colej4/drone/flight-controller/BMI270/BMI270.step

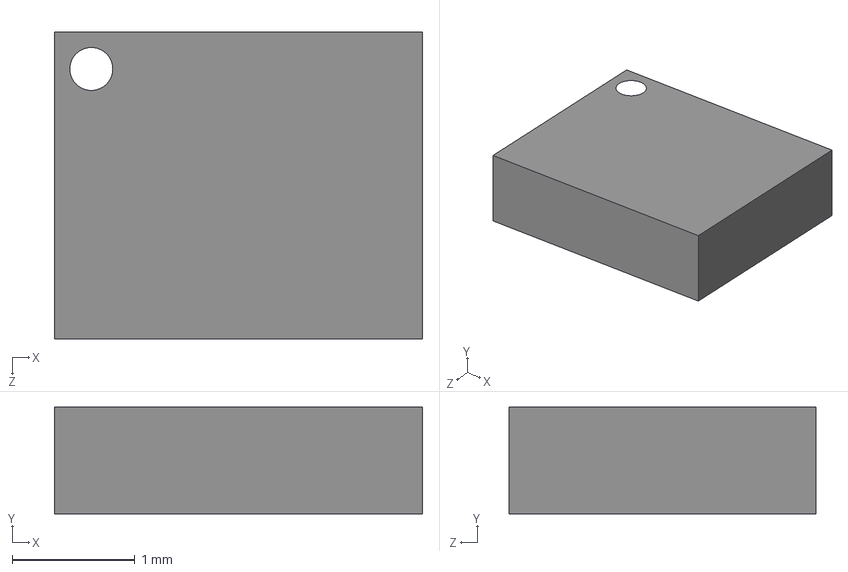
[picture p1: CAD file, 2026-03-21]
flight-controller/BMI270/BMI270.step
3.00 x 0.87 x 2.50 mm
