colej4/drone/flight-controller/BMP581/BMP581.step

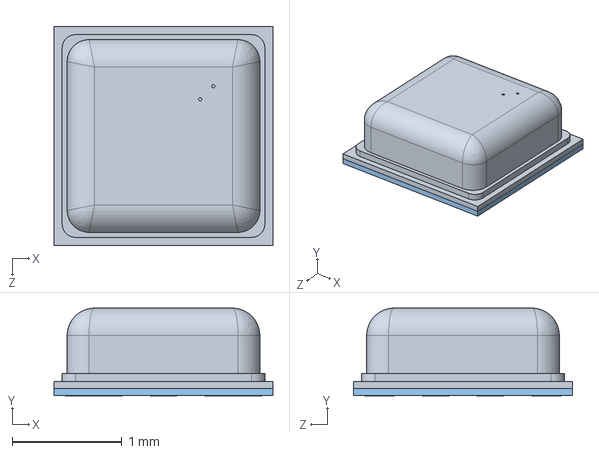
[picture p2: CAD file, 2026-03-21]
flight-controller/BMP581/BMP581.step
2.00 x 0.801 x 2.00 mm
