colej4/drone/flight-controller/MMC5983MA/MMC5983MA.step

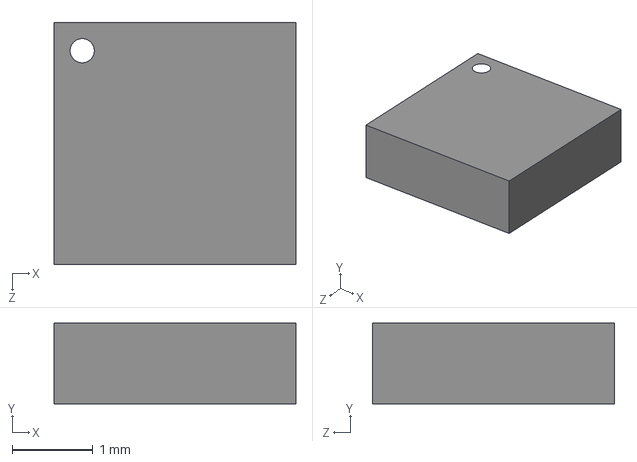
[picture p3: CAD file, 2026-03-21]
flight-controller/MMC5983MA/MMC5983MA.step
3.00 x 1.00 x 3.00 mm
