colej4/drone/flight-controller/MSD_4_A/MSD-4-A.step

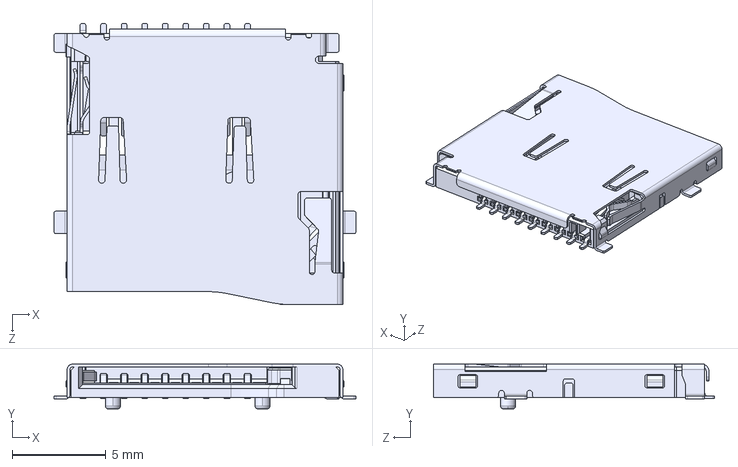
[picture p4: CAD file, 2026-03-25]
flight-controller/MSD_4_A/MSD-4-A.step
16.1 x 2.40 x 15.0 mm
