colej4/drone/flight-controller/TPS629210DRLR/TPS629210DRLR.step

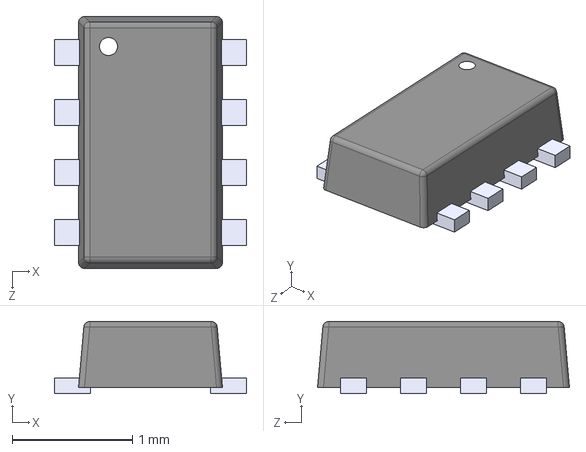
[picture p5: CAD file, 2026-03-25]
flight-controller/TPS629210DRLR/TPS629210DRLR.step
1.60 x 0.6 x 2.10 mm
