colej4/drone/flight-controller/FlightController.kicad_pcb

## KiCad design flight-controller/FlightController.kicad_pcb (2026-03-29)

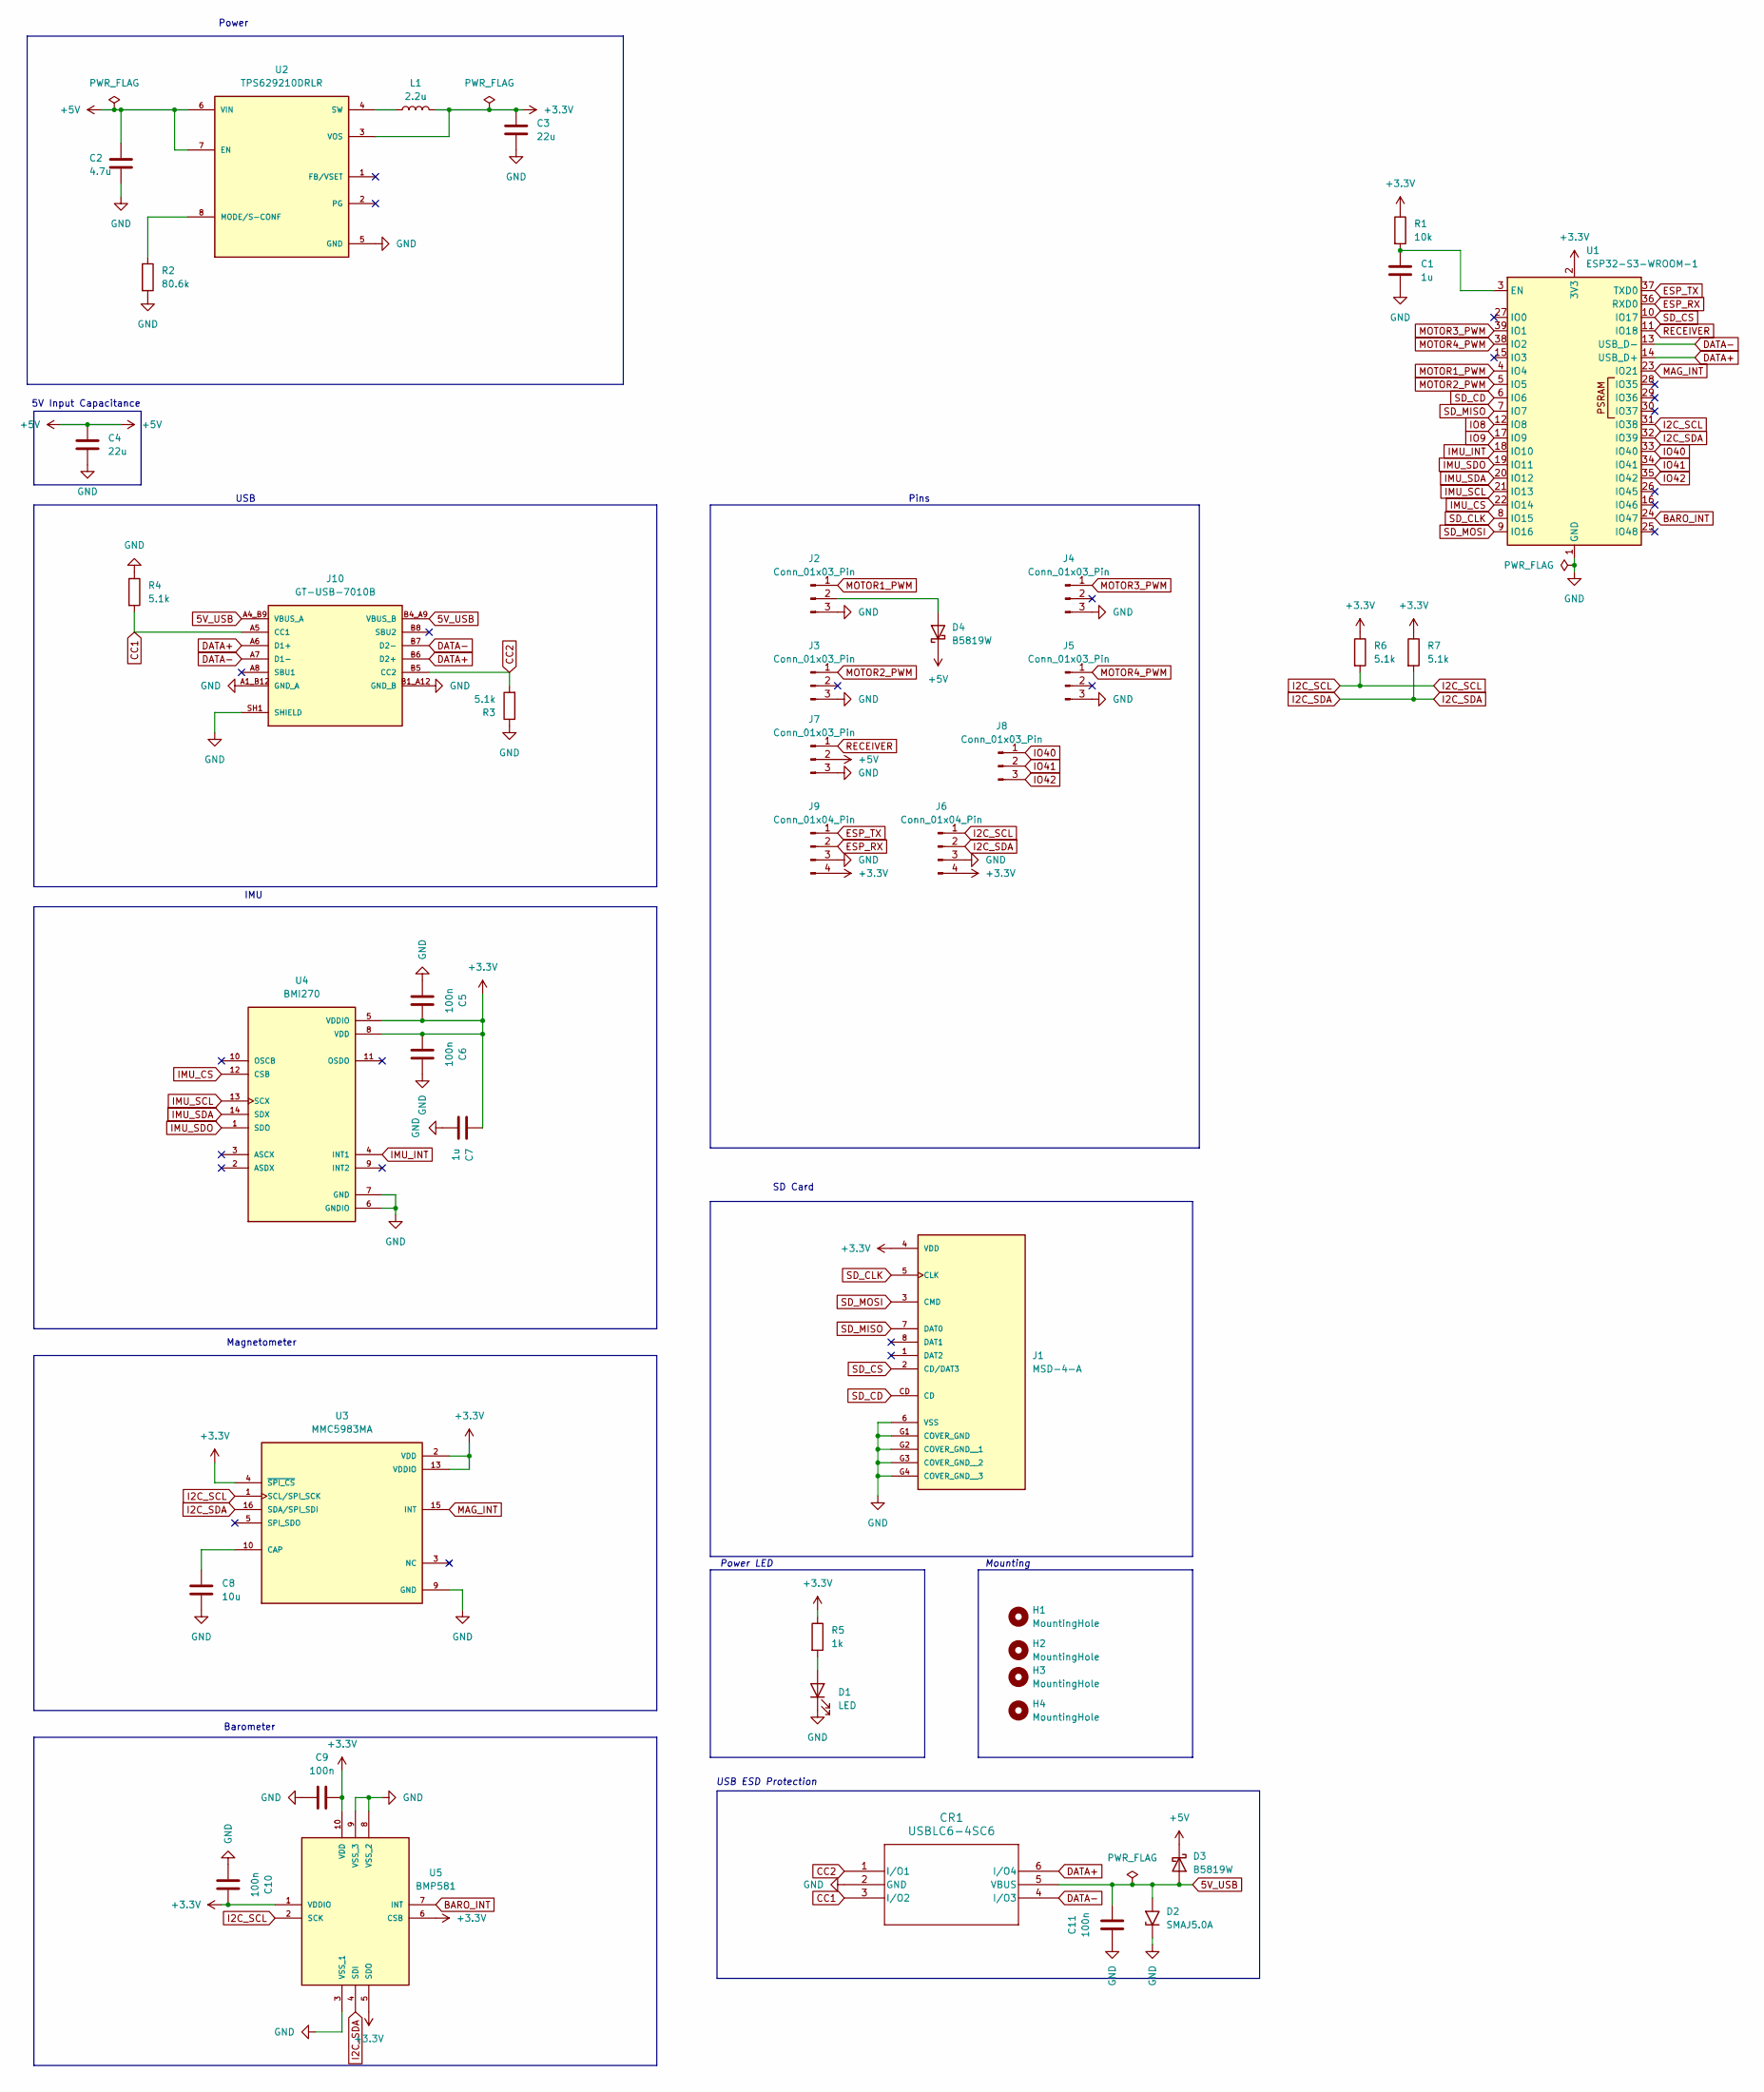
[picture p6: schematic FlightController.kicad_sch]

Parts:
C1, C7: 1u; C_0603_1608Metric_Pad1.08x0.95mm_HandSolder
C2: 4.7u; C_0603_1608Metric_Pad1.08x0.95mm_HandSolder
C3, C4: 22u; C_0603_1608Metric_Pad1.08x0.95mm_HandSolder
C5, C6, C9, C10, C11: 100n; C_0603_1608Metric_Pad1.08x0.95mm_HandSolder
C8: 10u; C_0603_1608Metric_Pad1.08x0.95mm_HandSolder
CR1: USBLC6-4SC6; SOT23-6L_STM
D1: LED; LED_0805_2012Metric
D2: SMAJ5.0A; D_SMA
D3, D4: B5819W; D_SOD-123
H1, H2, H3, H4: MountingHole; MountingHole_3.2mm_M3
J1: MSD-4-A; CUI_MSD-4-A; PARTREV 1.0
J2, J3, J4, J5, J7, J8: Conn_01x03_Pin; PinHeader_1x03_P2.54mm_Vertical
J6, J9: Conn_01x04_Pin; PinHeader_1x04_P2.54mm_Vertical
J10: GT-USB-7010B; G-SWITCH_GT-USB-7010B; PARTREV A0
L1: 2.2u; L_1008_2520Metric_Pad1.43x2.20mm_HandSolder
R1: 10k; R_0603_1608Metric_Pad0.98x0.95mm_HandSolder
R2: 80.6k; R_0603_1608Metric_Pad0.98x0.95mm_HandSolder
R3, R4, R6, R7: 5.1k; R_0603_1608Metric_Pad0.98x0.95mm_HandSolder
R5: 1k; R_0603_1608Metric_Pad0.98x0.95mm_HandSolder
U1: ESP32-S3-WROOM-1
U2: TPS629210DRLR; SOT50P160X60-8N; PARTREV B
U3: MMC5983MA; PQFN50P300X300X100-16N; PARTREV A
U4: BMI270; XDCR_BMI270
U5: BMP581; Manufacturer_Part_Number BMP581

Connections:
5V_USB: C11.2, CR1.5 (VBUS), D2.2 (A2), D3.2 (A), J10.A4_B9 (VBUS_A), J10.B4_A9 (VBUS_B)
+3.3V: C3.1, C5.2, C6.1, C7.2, C9.2, C10.2, J1.4 (VDD), J6.4, J9.4, L1.2, R1.1, R5.1, R6.1, R7.1, U1.2 (3V3), U2.3 (VOS), U3.2 (VDD), U3.4 (~SPI_CS), U3.13 (VDDIO), U4.5 (VDDIO), U4.8 (VDD), U5.1 (VDDIO), U5.5 (SDO), U5.6 (CSB), U5.10 (VDD)
+5V: C2.2, C4.1, D3.1 (K), D4.1 (K), J7.2, U2.6 (VIN), U2.7 (EN)
BARO_INT: U1.24 (IO47), U5.7 (INT)
CC1: CR1.3 (I/O2), J10.A5 (CC1), R4.2
CC2: CR1.1 (I/O1), J10.B5 (CC2), R3.2
DATA+: CR1.6 (I/O4), J10.A6 (D1+), J10.B6 (D2+), U1.14 (USB_D+)
DATA-: CR1.4 (I/O3), J10.A7 (D1-), J10.B7 (D2-), U1.13 (USB_D-)
ESP_RX: J9.2, U1.36 (RXD0)
ESP_TX: J9.1, U1.37 (TXD0)
GND: C1.2, C2.1, C3.2, C4.2, C5.1, C6.2, C7.1, C8.2, C9.1, C10.1, C11.1, CR1.2 (GND), D1.1 (K), D2.1 (A1), J1.6 (VSS), J1.G1 (COVER_GND), J1.G2 (COVER_GND__1), J1.G3 (COVER_GND__2), J1.G4 (COVER_GND__3), J2.3, J3.3, J4.3, J5.3, J6.3, J7.3, J9.3, J10.A1_B12 (GND_A), J10.B1_A12 (GND_B), J10.SH1 (SHIELD), J10.SH2 (SHIELD), J10.SH3 (SHIELD), J10.SH4 (SHIELD), R2.2, R3.1, R4.1, U1.1 (GND), U1.40 (GND), U1.41 (GND), U2.5 (GND), U3.9 (GND), U3.11 (GND), U4.6 (GNDIO), U4.7 (GND), U5.3 (VSS_1), U5.8 (VSS_2), U5.9 (VSS_3)
I2C_SCL: J6.1, R6.2, U1.31 (IO38), U3.1 (SCL/SPI_SCK), U5.2 (SCK)
I2C_SDA: J6.2, R7.2, U1.32 (IO39), U3.16 (SDA/SPI_SDI), U5.4 (SDI)
IMU_CS: U1.22 (IO14), U4.12 (CSB)
IMU_INT: U1.18 (IO10), U4.4 (INT1)
IMU_SCL: U1.21 (IO13), U4.13 (SCX)
IMU_SDA: U1.20 (IO12), U4.14 (SDX)
IMU_SDO: U1.19 (IO11), U4.1 (SDO)
IO8: U1.12 (IO8)
IO9: U1.17 (IO9)
IO40: J8.1, U1.33 (IO40)
IO41: J8.2, U1.34 (IO41)
IO42: J8.3, U1.35 (IO42)
MAG_INT: U1.23 (IO21), U3.15 (INT)
MOTOR1_PWM: J2.1, U1.4 (IO4)
MOTOR2_PWM: J3.1, U1.5 (IO5)
MOTOR3_PWM: J4.1, U1.39 (IO1)
MOTOR4_PWM: J5.1, U1.38 (IO2)
unnamed: D1.2 (A), R5.2
unnamed: D4.2 (A), J2.2
unnamed: C1.1, R1.2, U1.3 (EN)
unnamed: R2.1, U2.8 (MODE/S-CONF)
unnamed: L1.1, U2.4 (SW)
unnamed: C8.1, U3.10 (CAP)
RECEIVER: J7.1, U1.11 (IO18)
SD_CD: J1.CD, U1.6 (IO6)
SD_CLK: J1.5 (CLK), U1.8 (IO15)
SD_CS: J1.2 (CD/DAT3), U1.10 (IO17)
SD_MISO: J1.7 (DAT0), U1.7 (IO7)
SD_MOSI: J1.3 (CMD), U1.9 (IO16)

Notes on the sheet:
Magnetometer
Mounting
5V Input Capacitance
Pins
USB ESD Protection
SD Card
Barometer
Power LED
USB
IMU
Power

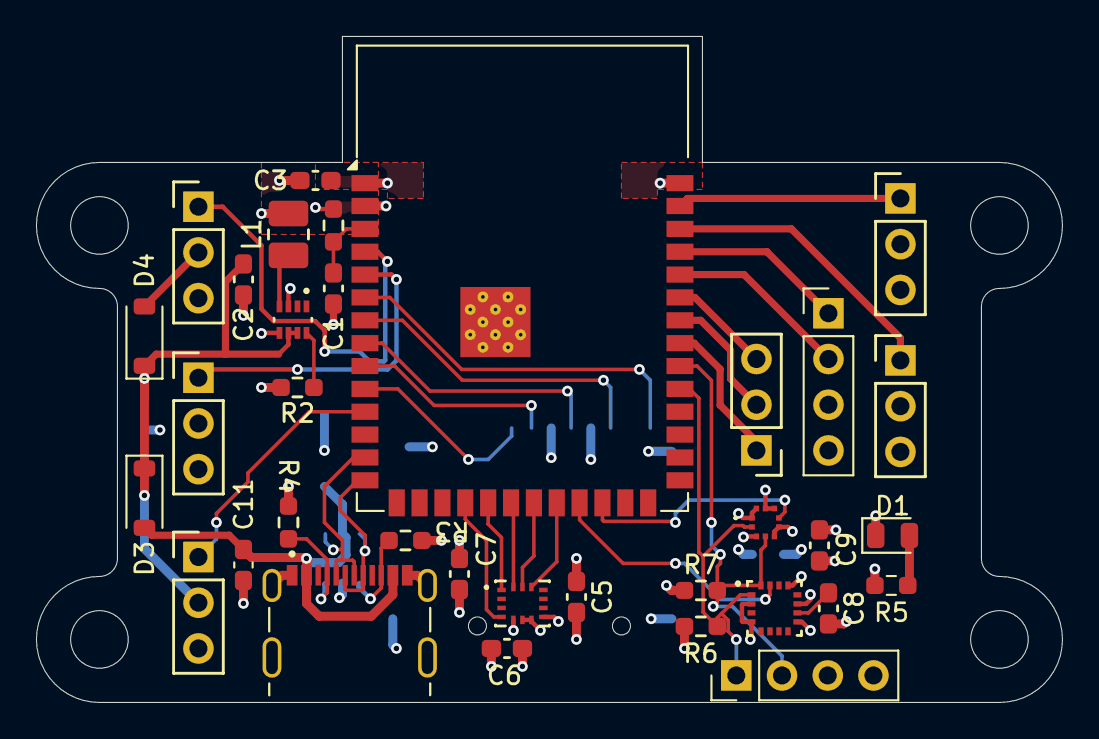
[picture p7: board FlightController.kicad_pcb from above]

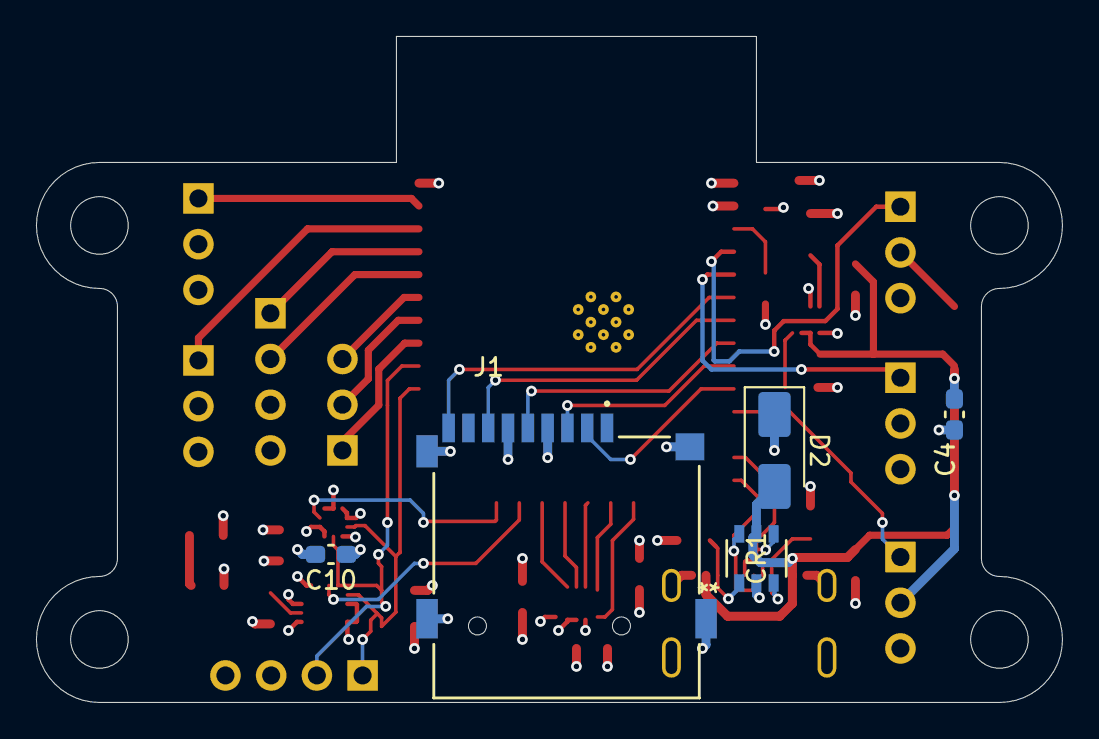
[picture p8: board FlightController.kicad_pcb from below]

Board: 4 copper layers, 57.0 x 37.0 mm, 43 parts (5 on the bottom side), 38 nets.
