colej4/drone/drone-code/main/wifi.cpp

#include <string.h>

#include "freertos/FreeRTOS.h"
#include "freertos/event_groups.h"

#include "esp_wifi.h"
#include "esp_event.h"
#include "esp_log.h"
#include "nvs_flash.h"
#include "wifi.hpp"

#include "lwip/ip_addr.h"

// Include WiFi credentials, file is gitignored - it just defines WIFI_SSID and WIFI_PASS
#include "wifi_login.h"

static const char *TAG = "wifi";

static EventGroupHandle_t s_wifi_event_group;
#define WIFI_CONNECTED_BIT BIT0

static void wifi_event_handler(void *arg,
                               esp_event_base_t event_base,
                               int32_t event_id,
                               void *event_data)
{
    if (event_base == WIFI_EVENT) {

        if (event_id == WIFI_EVENT_STA_START) {
            ESP_LOGI(TAG, "WiFi started, connecting...");
            // wifi_scan_start_async();
            esp_wifi_connect();
        }

        else if (event_id == WIFI_EVENT_STA_DISCONNECTED) {
            const wifi_event_sta_disconnected_t *e =
                (const wifi_event_sta_disconnected_t *)event_data;
            ESP_LOGW(TAG, "Disconnected, reason=%d", e->reason);
            esp_wifi_connect();
            xEventGroupClearBits(s_wifi_event_group, WIFI_CONNECTED_BIT);
        }

    } else if (event_base == IP_EVENT) {

        if (event_id == IP_EVENT_STA_GOT_IP) {
            ip_event_got_ip_t *event = (ip_event_got_ip_t *)event_data;
            ESP_LOGI(TAG, "Got IP: " IPSTR, IP2STR(&event->ip_info.ip));
            xEventGroupSetBits(s_wifi_event_group, WIFI_CONNECTED_BIT);
        }
    } 
}

void wifi_init_sta(void)
{
    s_wifi_event_group = xEventGroupCreate();

    esp_err_t ret = nvs_flash_init();
    if (ret == ESP_ERR_NVS_NO_FREE_PAGES ||
        ret == ESP_ERR_NVS_NEW_VERSION_FOUND) {
        nvs_flash_erase();
        nvs_flash_init();
    }

    ESP_ERROR_CHECK(esp_netif_init());

    ESP_ERROR_CHECK(esp_event_loop_create_default());

    esp_netif_create_default_wifi_sta();

    wifi_init_config_t cfg = WIFI_INIT_CONFIG_DEFAULT();
    ESP_ERROR_CHECK(esp_wifi_init(&cfg));

    ESP_ERROR_CHECK(esp_event_handler_register(
        WIFI_EVENT, ESP_EVENT_ANY_ID, &wifi_event_handler, NULL));
    ESP_ERROR_CHECK(esp_event_handler_register(
        IP_EVENT, IP_EVENT_STA_GOT_IP, &wifi_event_handler, NULL));

    wifi_config_t wifi_config = {};
    strncpy((char*)wifi_config.sta.ssid, (const char*)WIFI_SSID, sizeof(wifi_config.sta.ssid) - 1);
    strncpy((char*)wifi_config.sta.password, (const char*)WIFI_PASS, sizeof(wifi_config.sta.password) - 1);
    wifi_config.sta.pmf_cfg.capable = true;
    wifi_config.sta.pmf_cfg.required = false;

    ESP_ERROR_CHECK(esp_wifi_set_mode(WIFI_MODE_STA));
    ESP_ERROR_CHECK(esp_wifi_set_config(WIFI_IF_STA, &wifi_config));
    ESP_ERROR_CHECK(esp_wifi_start());
}

void wait_for_wifi(void)
{
    xEventGroupWaitBits(
        s_wifi_event_group,
        WIFI_CONNECTED_BIT,
        pdFALSE,
        pdTRUE,
        portMAX_DELAY
    );
}
