colej4/drone/(commit log)

2025-11-24 draft of pid controller + task
2025-11-27 imu code + some joystick stuff
2025-12-04 imu bias and calibration
2026-01-19 fix recovery for IBUS packet header
    [ibus_protocol.c]
2026-02-01 modify some params for new props after flight test
2026-02-01 switch printing to use esp_log
2026-02-04 cascading P and PID loop in matlab
2026-02-07 cascading pid, tuning and logging changes
2026-02-27 Update matlab model to reflect better prop model and retune params
2026-02-27 interrupt based imu for proper 1khz polling
2026-03-05 increase gains, fix eigen
    [control.cpp, feedforward.cpp, feedforward.hpp, imu.cpp, math_helpers.hpp, state_estimator.cpp]
2026-03-19 5V -> 3.3V DC-DC
    [FlightController.kicad_pcb, FlightController.kicad_sch]
2026-03-20 switch to new esp with native usb
    [FlightController.kicad_sch]
2026-03-21 Add a bunch of sensors
    [BMI270.step, BMP581.step, FlightController.kicad_sch, MMC5983MA.step]
2026-03-25 schematic should be done
    [FlightController.kicad_sch, TPS629210DRLR.step]
2026-03-25 update usb
    [FlightController.kicad_sch]
2026-03-25 add footprints
    [FlightController.kicad_pcb, FlightController.kicad_sch, MSD-4-A.step]
2026-03-25 general component locations
    [FlightController.kicad_pcb, FlightController.kicad_sch]
2026-03-25 DRC no errors
    [FlightController.kicad_pcb]
2026-03-26 first draft with layout
    [FlightController.kicad_pcb]
2026-03-26 add uart header
    [FlightController.kicad_pcb, FlightController.kicad_sch]
2026-03-26 add mounting holes
    [FlightController.kicad_pcb, FlightController.kicad_sch]
2026-03-27 esd protection
    [FlightController.csv]
2026-03-27 switch usb port, add schottky diode
    [FlightController.kicad_pcb, FlightController.kicad_sch]
2026-03-29 design files
    [FlightController.csv, FlightController.kicad_sch, bom.csv, designators.csv, positions.csv]
2026-03-29 4 layerify board
    [FlightController.kicad_pcb]
